choosye/Cyberdeckie/BOM.csv

Item | Qty | Supplier | Cost/item | Total Cost | link
TYPE-C-31-M-12 | 1 | LCSC | $0.87 | $0.87 | https://www.lcsc.com/product-detail/C165948.html
TS-1187A-B-A-B | 60 | LCSC | $0.03 | $1.80 | https://www.lcsc.com/product-detail/C318884.html
C3011084 Diode | 50 | LCSC | $0.01 | $0.50 | https://www.lcsc.com/product-detail/C3011084.html
C2998822 FPC Connector | 10 | LCSC | $0.10 | $1.00 | https://www.lcsc.com/product-detail/C2998822.html
BQ24074 charger chip | 1 | LCSC | $5.45 | $5.45 | https://www.lcsc.com/product-detail/C54313.html
C431540 Slide Switch | 1 | LCSC | $0.52 | $0.52 | https://www.lcsc.com/product-detail/C431540.html
C919459 | 1 | LCSC | $1.15 | $1.15 | https://www.lcsc.com/product-detail/C919459.html
C285716 | 1 | LCSC | $0.63 | $0.63 | https://www.lcsc.com/product-detail/C285716.html
C21190 1k Resistor | 1 | LCSC | $0.16 | $0.16 | https://www.lcsc.com/product-detail/C21190.html
C22843 1.5k Resistor | 2 | LCSC | $0.10 | $0.20 | https://www.lcsc.com/product-detail/C22843.html
C23186 5.1k Resistor | 2 | LCSC | $0.08 | $0.16 | https://www.lcsc.com/product-detail/C23186.html
C25804 10k Resistor | 1 | LCSC | $0.16 | $0.16 | https://www.lcsc.com/product-detail/C25804.html
C25803 100k Resistor | 1 | LCSC | $0.28 | $0.28 | https://www.lcsc.com/product-detail/C25803.html
C22833 1.13k Resistor | 1 | LCSC | $0.19 | $0.19 | https://www.lcsc.com/product-detail/C22833.html
C22763 1.18k Resistor | 1 | LCSC | $0.16 | $0.16 | https://www.lcsc.com/product-detail/C22763.html
C23239 732k Resistor | 1 | LCSC | $0.24 | $0.24 | https://www.lcsc.com/product-detail/C23239.html
Capacitors | 1 | LCSC | $3.39 | $3.39 | https://lcsc.com
C131337 Connector Header | 1 | LCSC | $0.54 | $0.54 | https://www.lcsc.com/product-detail/C131337.html
C5173392 2x20 Header | 1 | LCSC | $1.26 | $1.26 | https://www.lcsc.com/product-detail/C5173392.html
LEDs | 1 | LCSC | $1.79 | $1.79 | https://lcsc.com
C3013203 46.4k Resistor | 1 | LCSC | $0.16 | $0.16 | https://www.lcsc.com/product-detail/C3013203.html
PCB | 1 | JLCPCB | $2.00 | $2.00 | https://jlcpcb.com
ST7796 Display | 1 | Aliexpress | $7.55 | $7.55 | https://www.aliexpress.com/item/1005012619618051.html?mp=1
FPC Cable | 1 | Aliexpress | $0.78 | $0.78 | https://www.aliexpress.com/item/1005008216923733.html?mp=1
C52016391 3 Pin Header | 1 | LCSC | $0.45 | $0.45 | https://www.lcsc.com/product-detail/C52016391.html
LiPo Battery | 1 | Aliexpress | $1.93 | $1.93 | https://www.aliexpress.com/item/1005009606905538.html?src=google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
Raspberry Pi Zero 2 W | 1 | element14 | $17.14 | $17.14 | https://sg.element14.com/raspberry-pi/rpi-zero-w-v2/sbc-rpi-zero-2-w-512mb-1ghz/dp/3838499
Estimated total shipping | 1 |  |  | $22.34
