choosye/Cyberdeckie/Hardware/Cyberdeckie Enclosure.step

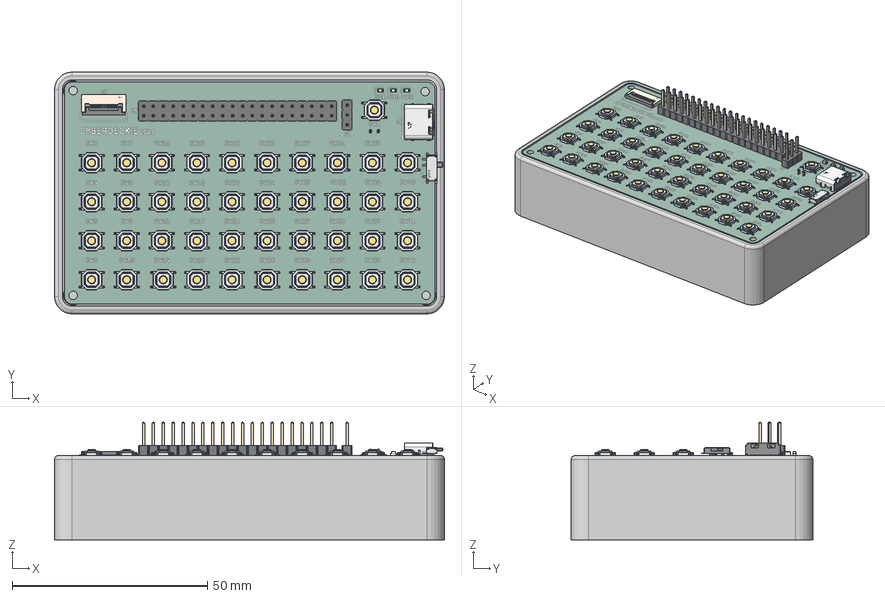
[picture p1: CAD file, 2026-11-13]
Hardware/Cyberdeckie Enclosure.step
100.0 x 62.0 x 30.1 mm
