choosye/Cyberdeckie/(list of files, cad)

Other CAD files:
Hardware/Cyberdeckie Enclosure.f3d
Hardware/Cyberdeckie Enclosure.stl
