choosye/Cyberdeckie/PCB/Cyberdeckie.kicad_pcb

## KiCad design PCB/Cyberdeckie.kicad_pcb (2026-11-13)

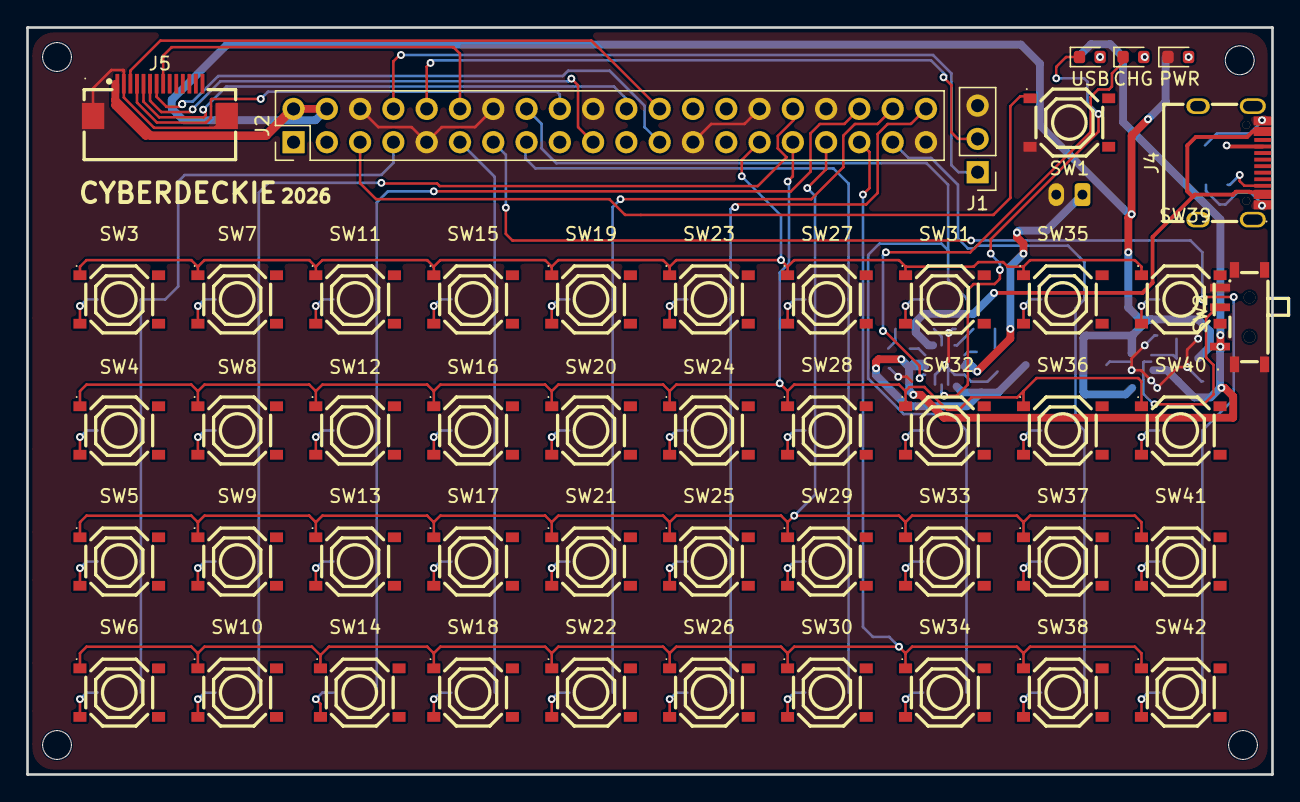
[picture p2: board Cyberdeckie.kicad_pcb from above]

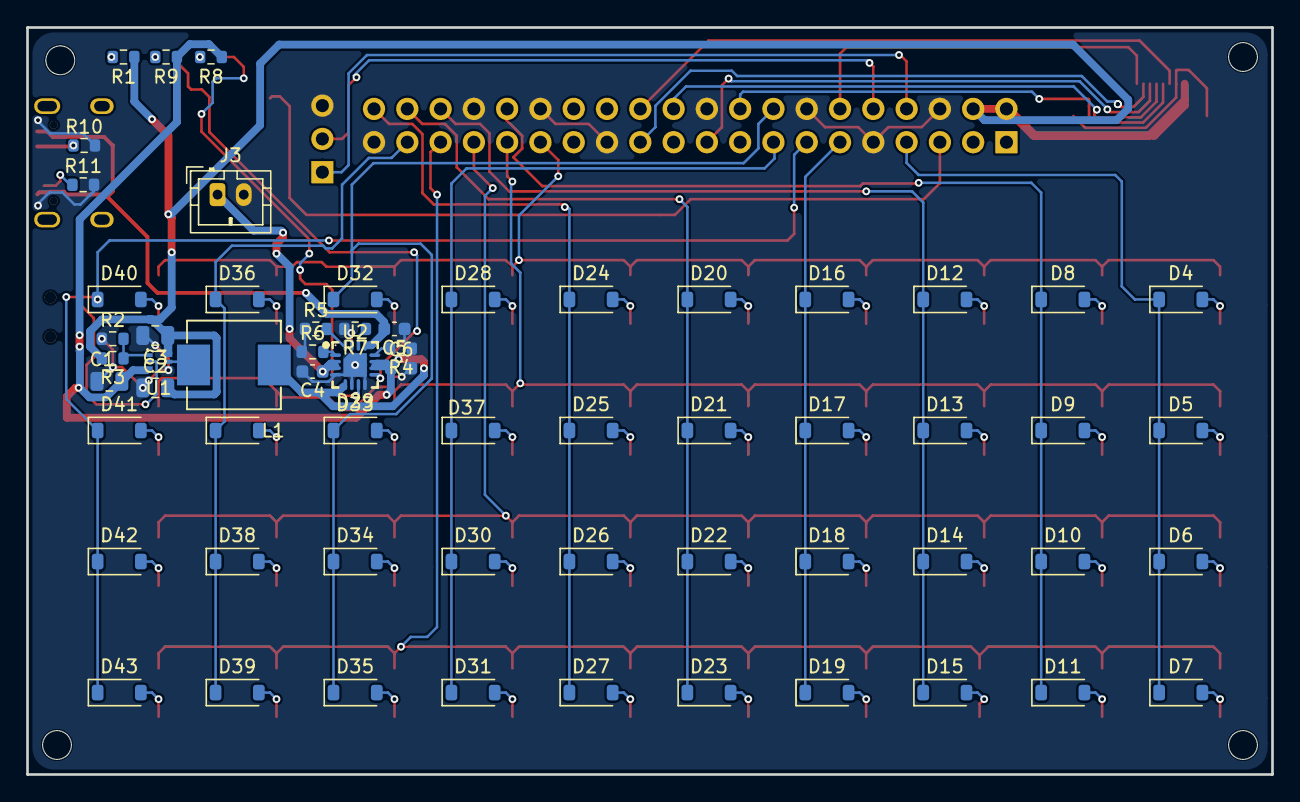
[picture p3: board Cyberdeckie.kicad_pcb from below]

Board: 2 copper layers, 95.0 x 57.0 mm, 110 parts (61 on the bottom side), 82 nets.

Parts:
C1: 10uF; C_0805_2012Metric
C2, C3: 22uF; C_0805_2012Metric
C4, C6: 4.7uF; C_0603_1608Metric
C5: 1uF; C_0603_1608Metric
D1, D2, D3: LED; LED_0603_1608Metric
D4, D5, D6, D7, D8, D9, D10, D11, D12, D13, D14, D15, D16, D17, D18, D19, D20, D21, D22, D23, D24, D25, D26, D27, D28, D29, D30, D31, D32, D33, D34, D35, D36, D37, D38, D39, D40, D41, D42, D43: D; D_SOD-123
J1: Serial Debug; PinHeader_1x03_P2.54mm_Vertical
J2: Raspberry_Pi_Zero_2_W; PinHeader_2x20_P2.54mm_Vertical
J3: Battery (JST-PH); JST_PH_B2B-PH-K_1x02_P2.00mm_Vertical
J4: TYPE-C-31-M-12; USB-C_SMD-TYPE-C-31-M-12_1
J5: ST7796 3.5in Display (FPC); FPC-SMD_14P-P0.50_DEALON_FC05-S14FCT-00
L1: 1uH; IND-SMD_L7.3-W6.6_MHCI06030
R1: 1k; R_0603_1608Metric
R2: 100k; R_0603_1608Metric
R3: 732k; R_0603_1608Metric
R4: 1.18k; R_0603_1608Metric
R5: 1.13k; R_0603_1608Metric
R6: 10k; R_0603_1608Metric
R7: 46.4k; R_0603_1608Metric
R8, R9: 1.5k; R_0603_1608Metric
R10, R11: 5.1; R_0603_1608Metric
SW1, SW3, SW4, SW5, SW6, SW7, SW8, SW9, SW10, SW11, SW12, SW13, SW14, SW15, SW16, SW17, SW18, SW19, SW20, SW21, SW22, SW23, SW24, SW25, SW26, SW27, SW28, SW29, SW30, SW31, SW32, SW33, SW34, SW35, SW36, SW37, SW38, SW39, SW40, SW41, SW42: TS-1187A-B-A-B; SW-SMD_4P-L5.1-W5.1-P3.70-LS6.5-TL_H1.5
SW2: MSK12C02; SW-TH_MSK12C02
U1: TPS61023DRLR; SOT-563_L1.6-W1.2-P0.50-LS1.6-BR
U2: BQ24074RGTR; QFN-16_L3.0-W3.0-P0.50-TL-EP1.7

Connections:
+5V: C2.2, C3.1, J2.2 (5V), J2.4 (5V), J5.1, R1.1, R3.2, U1.6 (VOUT)
COL0: D4.1 (K), D5.1 (K), D6.1 (K), D7.1 (K), J2.7 (GCLK0/GPIO4)
COL1: D8.1 (K), D9.1 (K), D10.1 (K), D11.1 (K), J2.32 (PWM0/GPIO12)
COL2: D12.1 (K), D13.1 (K), D14.1 (K), D15.1 (K), J2.36 (GPIO16)
COL3: D16.1 (K), D17.1 (K), D18.1 (K), D19.1 (K), J2.11 (GPIO17)
COL4: D20.1 (K), D21.1 (K), D22.1 (K), D23.1 (K), J2.38 (GPIO20/MOSI1)
COL5: D24.1 (K), D25.1 (K), D26.1 (K), D27.1 (K), J2.40 (GPIO21/SCLK1)
COL6: D28.1 (K), D29.1 (K), D30.1 (K), D31.1 (K), J2.15 (GPIO22)
COL7: D32.1 (K), D33.1 (K), D34.1 (K), D35.1 (K), J2.16 (GPIO23)
COL8: D36.1 (K), D37.1 (K), D38.1 (K), D39.1 (K), J2.37 (GPIO26)
COL9: D40.1 (K), D41.1 (K), D42.1 (K), D43.1 (K), J2.13 (GPIO27)
GND: C1.1, C2.1, C3.2, C4.2, C5.1, C6.2, D1.1 (K), J1.3, J2.6 (GND), J2.9 (GND), J2.14 (GND), J2.20 (GND), J2.25 (GND), J2.30 (GND), J2.34 (GND), J2.39 (GND), J3.2, J4.A1B12 (GND), J4.B1A12 (GND), J5.2, J5.15, J5.16, R2.1, R4.1, R5.1, R6.1, R7.2, R10.2, R11.2, SW1.3 (C), SW2.3, SW2.4, U1.4 (GND), U2.4 (~CE), U2.6 (EN1), U2.8 (VSS), U2.17 (EP)
LCD_BL: J2.12 (GPIO18/PWM0), J5.8
LCD_CS: J2.24 (~CE0/GPIO8), J5.3
LCD_DC: J2.22 (GPIO25), J5.5
LCD_MOSI: J2.19 (MOSI0/GPIO10), J5.6
LCD_RST: J2.18 (GPIO24), J5.4
LCD_SCK: J2.23 (SCLK0/GPIO11), J5.7
unnamed: D1.2 (A), R1.2
unnamed: D2.2 (A), R8.1
unnamed: D2.1 (K), U2.7 (~PGOOD)
unnamed: D3.2 (A), R9.1
unnamed: D3.1 (K), U2.9 (~CHG)
unnamed: D4.2 (A), SW3.3 (C)
unnamed: D5.2 (A), SW4.3 (C)
unnamed: D6.2 (A), SW5.3 (C)
unnamed: D7.2 (A), SW6.3 (C)
unnamed: D8.2 (A), SW7.3 (C)
unnamed: D9.2 (A), SW8.3 (C)
unnamed: D10.2 (A), SW9.3 (C)
unnamed: D11.2 (A), SW10.3 (C)
unnamed: D12.2 (A), SW11.3 (C)
unnamed: D13.2 (A), SW12.3 (C)
unnamed: D14.2 (A), SW13.3 (C)
unnamed: D15.2 (A), SW14.3 (C)
unnamed: D16.2 (A), SW15.3 (C)
unnamed: D17.2 (A), SW16.3 (C)
unnamed: D18.2 (A), SW17.3 (C)
unnamed: D19.2 (A), SW18.3 (C)
unnamed: D20.2 (A), SW19.3 (C)
unnamed: D21.2 (A), SW20.3 (C)
unnamed: D22.2 (A), SW21.3 (C)
unnamed: D23.2 (A), SW22.3 (C)
unnamed: D24.2 (A), SW23.3 (C)
unnamed: D25.2 (A), SW24.3 (C)
unnamed: D26.2 (A), SW25.3 (C)
unnamed: D27.2 (A), SW26.3 (C)
unnamed: D28.2 (A), SW27.3 (C)
unnamed: D29.2 (A), SW28.3 (C)
unnamed: D30.2 (A), SW29.3 (C)
unnamed: D31.2 (A), SW30.3 (C)
unnamed: D32.2 (A), SW31.3 (C)
unnamed: D33.2 (A), SW32.3 (C)
unnamed: D34.2 (A), SW33.3 (C)
unnamed: D35.2 (A), SW34.3 (C)
unnamed: D36.2 (A), SW35.3 (C)
unnamed: D37.2 (A), SW36.3 (C)
unnamed: D38.2 (A), SW37.3 (C)
unnamed: D39.2 (A), SW38.3 (C)
unnamed: D40.2 (A), SW39.3 (C)
unnamed: D41.2 (A), SW40.3 (C)
unnamed: D42.2 (A), SW41.3 (C)
unnamed: D43.2 (A), SW42.3 (C)
unnamed: J4.A5 (CC1), R10.1
unnamed: J4.B5 (CC2), R11.1
unnamed: SW2.2, U1.2 (EN)
unnamed: R2.2, R3.1, U1.1 (FB)
unnamed: L1.2, U1.5 (SW)
unnamed: R4.2, U2.12 (ILIM)
unnamed: R5.2, U2.16 (ISET)
unnamed: R7.1, U2.14 (TMR)
unnamed: R6.2, U2.1 (TS)
ROW0: J2.29 (GCLK1/GPIO5), SW3.1 (A), SW7.1 (A), SW11.1 (A), SW15.1 (A), SW19.1 (A), SW23.1 (A), SW27.1 (A), SW31.1 (A), SW35.1 (A), SW39.1 (A)
ROW1: J2.31 (GCLK2/GPIO6), SW4.1 (A), SW8.1 (A), SW12.1 (A), SW16.1 (A), SW20.1 (A), SW24.1 (A), SW28.1 (A), SW32.1 (A), SW36.1 (A), SW40.1 (A)
ROW2: J2.33 (PWM1/GPIO13), SW5.1 (A), SW9.1 (A), SW13.1 (A), SW17.1 (A), SW21.1 (A), SW25.1 (A), SW29.1 (A), SW33.1 (A), SW37.1 (A), SW41.1 (A)
ROW3: J2.35 (GPIO19/MISO1), SW6.1 (A), SW10.1 (A), SW14.1 (A), SW18.1 (A), SW22.1 (A), SW26.1 (A), SW30.1 (A), SW34.1 (A), SW38.1 (A), SW42.1 (A)
SHUTDOWN: J2.5 (SCL/GPIO3), SW1.1 (A)
UART_RX: J1.2, J2.10 (GPIO15/RXD)
UART_TX: J1.1, J2.8 (GPIO14/TXD)
VBAT: C4.1, J3.1, U2.2 (BAT), U2.3 (BAT)
VBUS: C5.2, J4.A4B9 (VBUS), J4.B4A9 (VBUS), U2.13 (IN)
VSYS: C1.2, C6.1, L1.1, R8.2, R9.2, SW2.1, U1.3 (VIN), U2.5 (EN2), U2.10 (OUT), U2.11 (OUT)
