choosye/Cyberdeckie/JOURNAL.md

# Cyberdeckie: devlog

<!-- Generated by Half Life from project c2gtuuxphvi9iicwg3xbcl76. Edits here are overwritten on the next sync. -->
<!-- Generated: 2026-11-13T23:14:41.680Z -->

> [!NOTE]
> This devlog is mirrored from [Half Life](https://halflife.hackclub.com) ([open the project](https://halflife.hackclub.com/projects/c2gtuuxphvi9iicwg3xbcl76)). Editing it here will not change the platform's copy, and the next sync overwrites this file.

> A custom-built cyberdeck from scratch!! A tiny Linux-based computer that will make you feel like a hacker from the '90s!

| Week | Tier | Hours logged | Entries |
| --- | --- | --- | --- |
| Week 5 | Tier 2 | 36.75h | 9 |

## Contents

1. [2026-11-09: Starting off Cyberdeckie](#2026-11-09-starting-off-cyberdeckie)
2. [2026-11-10: Making the schematic for power parts; the big learning point](#2026-11-10-making-the-schematic-for-power-parts-the-big-lear)
3. [2026-11-10: 10/11: Completing the schematic](#2026-11-10-1011-completing-the-schematic)
4. [2026-11-11: 11/11: PCB Editing time!!!](#2026-11-11-1111-pcb-editing-time)
5. [2026-11-11: 11/11: Finishing up the PCB YAYYYY](#2026-11-11-1111-finishing-up-the-pcb-yayyyy)
6. [2026-11-12: 12/11: ROUTING TIME!](#2026-11-12-1211-routing-time)
7. [2026-11-13: 13/11: Last last session to really complete the PCB](#2026-11-13-1311-last-last-session-to-really-complete-the-pcb)
8. [2026-11-13: 13/11: Last stretch! Finding and creating the BOM](#2026-11-13-1311-last-stretch-finding-and-creating-the-bom)
9. [2026-11-13: Creating the Enclosure](#2026-11-13-creating-the-enclosure)

## Design

### 2026-11-09: Starting off Cyberdeckie

**4h**

Starting off Cyberdeckie

CyberdeckieSS0
Screenshot 2026-11-09 at 9.05.02 AM
First off, I had to pick which parts to use for my cyberdeckie. It took a considerable amount of time to find everything. Managed to get most of the parts from lcsc, so that’s good! After that, i downloaded all of the datasheets so that i could refer to them when making the schematic.

CyberdeckieSS1
CyberdeckieSS2
Started on the schematic!! For this project, I made multiple pages, grouping them into RPi, Power, Display and Keyboard. Started with the Raspberry Pi and added the net labels.

### 2026-11-10: Making the schematic for power parts; the big learning point

**5.75h**

Making the schematic for power parts; the big learning point

CyberdeckieSS3
Started with the USB-C, which was quite straightforward. Referred to the datasheet pinout
Looking back now I actually accidentally added vbus as a net label, not a power symbol so I’ll go change that haha

CyberdeckieSS5
Got to the most tedious and challenging part of the schematic, the battery charger (BQ24074)… but i definitely did learn the most here.
So uhhhhh when i saw this my brain couldn’t even process it.. but! I tried to connect whatever I understood first, like connected the pins to the ground.

CyberdeckieSS6
And then came the mighty Google: understanding what the symbols stand for 🫣 i did end up using a diff pic cos this one wasn’t as helpful as the others
This was a great help. Well actually the datasheet did help a ton, especially after I understood it all. After that, i connected the capacitors (which were actually really easy I just didn’t know what they were at first), and then everything else came slowly.

CyberdeckieSS7
Progress! Rough, but progress! Relied a LOT on the datasheet for this component. Also realised that since I was working with different pages, I had to use global net labels, so I switched them all!

CyberdeckieSS8
After I kinda got everything, I ran the ERC and wow so many errors! Turns out something moved in my RPi page and a ton of labels weren’t connected so I moved them back and yayyyy settled :D

CyberdeckieSS9
Lastly, I decided to clean up my power page and labels too bc some of them were kinda redundant. After that, everything was much neater :) Also added the necessary power flags and yay done with the power page fully!

Really didn’t expect to spend so so much time with this page but i definitely did learn a lot. In the end, a lot of time was spent finding which symbols and labels to connect with the pins and also fixing mistakes made.

### 2026-11-10: 10/11: Completing the schematic

**4h**

10/11: Completing the schematic

CyberdeckieSS11
After doing up the power page, I moved on to making the schematic for the display, which was fairly simple.

CyberdeckieSS12
After that, I moved on to the keyboard! Oh gosh... so many keyss... Created the first switch and then duplicated the rows and columns. (Thank goodness for duplication!) However, I still had to change each switches net label to the corresponding one. Well that took a while!

CyberdeckieSS13
After the long long keyboard session, I went back to the RPi page to add a shutdown and button and serial debug header so that everything's safe!

CyberdeckieSS14
CyberdeckieSS15
After that, I ran the DRC to make sure everything was okay and yay omg no errors I love it! I also decided to run the 'annotate schematic' to make sure everything is labelled nicely and neatly :)

### 2026-11-11: 11/11: PCB Editing time!!!

**6.5h**

11/11: PCB Editing time!!!

It was finally time to update the schematic to the PCB!! Well, I was really really excited to move on to the PCB, so I totally forgot about the assigning of footprints so... yeah I ran into a bunch of errors when I tried to update the PCB. whoops!

CyberdeckieSS16
Updated and found all of the footprints! Had to search for and download a few but it wasn't too bad so yayy

CyberdeckieSS17
Managed to updated the PCB from the schematic successfully!! But it wasn't a very pleasant surprise when I saw all of the components. I definitely did not see so many components before and I hadn't worked with these especially, so uh well it was new!

CyberdeckieSS18
I first tried separating the key switches and arrange the keyboard since it was the main part of the PCB. Well, this one took sooooooooooo much time omg I was gonna take my brains out for this. Especially since everything had to be placed specifically, I had to find the different switches one by one while referring to the schematic for which SW to place down. Oh gosh, it really took a lot of time for arranging the PCB.

Screenshot 2026-11-12 at 9.22.29 PM
YAY progress! It was still a little messy but I was getting the hang of putting the different switches in place and tidying the row to be on the same level. Wasn't too sure on how to tidy the columns yet though heh

Screenshot 2026-11-12 at 9.39.12 PM
FINALLY DONE with placing all of the switches! And then came the diodes...

Screenshot 2026-11-12 at 9.50.54 PM
Actually forgot B.cu existed so I was like omg do I have to place the diodes right beside the switches? but nope luckily not because we love B.cu and it's so much neater that way. Love just having to place them in the middle of the switch! This one also took a while since I had to find the individual diodes for the specific switches. Glad I managed to get that done though!

Screenshot 2026-11-12 at 11.06.47 PM
After getting the base keyboard down, I added in the rest of the larger components like the FPC connector, RPi connector and battery stuff. Did not want to touch the power components bc I did not know how I was supposed to do those and they were so much smaller than I imagined.

### 2026-11-11: 11/11: Finishing up the PCB YAYYYY

**4h**

11/11: Finishing up the PCB YAYYYY

Screenshot 2026-11-12 at 11.06.47 PM
First off, I added every single component into the PCB (except the Rs and Cs!) , since I left some out the last session. Had the power components on the B.cu so that everything would be neater! Plus, they weren't needed on the front side anyway.

Screenshot 2026-11-13 at 6.17.29 AM
After that, I focused on the power components (yeah did not expect how long it would eventually take...) Firstly, I wasn't even sure where to put the resistors. Yeah.
So, I had to pull out the good ol datasheet. Didn't think I'd have to use it again... But yes it was very useful.

Screenshot 2026-11-13 at 6.24.23 AM
After referring back and forth for who knows how long, I finally finally got the resistors to the best placement I could get. So now every component is in the PCB woohoo!

Screenshot 2026-11-13 at 6.29.15 AM
Ran the DRC and um..... Too many violations? Yeah so I googled it and apparentlyyyy it should be fine. Hopefully. Because yeah I ended up ignoring that + the clearance violations since I needed the slide switch and usb to be really near the edge.

Screenshot 2026-11-13 at 3.13.36 PM
I focused on completing the design of the PCB for this session so yay done after!

### 2026-11-12: 12/11: ROUTING TIME!

**6h**

12/11: ROUTING TIME!

Oohohohoh routing routing routing, the big boss. This one really took a toll on me TT^TT since there was so much to route for this project. (So far, they've been pretty simple since I'd just been following the guide).

Screenshot 2026-11-13 at 3.31.30 PM
Before starting, I made some additions to the board setup; making the track width for the power net class thicker so that more current for the power can flow through and it won't overheat too easily!

Screenshot 2026-11-13 at 4.10.28 PM
Starting off the routing, which I briefly forgot which key to press (x) but it was easy after the tiny refresher, I connected the pads on the key switches. Did the rows on F.cu and the columns on B.cu. Left some unconnected since there was a lot going on at the cluster of power components. This was the easiest part of routing. :(

Screenshot 2026-11-13 at 4.27.10 PM
After the key switches, I moved on to route as much as I could at the FPC connector yay! I learned that I had to make the routes as close as possible to leave enough space for more routing (experience!) I also tried to route all of the main column and row switches to the RPi pins. I definitely need to work on my routing looks wise, but its a lot better than my first few projects ;>

Screenshot 2026-11-13 at 4.49.15 PM
More, more, more routing!! Got a lot more done here, and tried to connect all of the GND pins first (which I would later deeply regret...) since I thought hey there are the most number of gnd pins let's do them first then
And these actually took quite long too :<

CyberdeckieSS20
Oh gosh ran into so many problems with this project. For this screenshot above, I was really frustrated because I couldn't seem to move the track anywhere. Literally. Apparently, it was because the track was too thick since it was a power pad and couldn't move past the gap between the R1 and hole. Omg. I  was stuck staring at this after putting it off for as long as I could already and just couldn't figure it out. Yeah so what I did in the end was creating pre-defined sizes for the track and switching to that instead. It worked like a charm.

Screenshot 2026-11-13 at 6.38.53 PM
Kinda forgot to take more screenshots so this is already after quite a while but some context here anyway: When I was trying to route all of the pins, especially those at the power components, I couldn't route them because they were all blocked by the multiple gnd tracks... It was so so so annoying but I still worked my way around it somehow(?) although it was really messy. However, there were 1 or 2 pins that just couldn't move because it was blocked by everything around and I couldn't swap it to F.cu either cos there was just not enough space. So, I googled a little here and there and of course I realised I didn't need to connect all of the gnd pads because there's a thing called gnd pour (week 1...) sigh so yeah I painstakingly removed all of the gnd connections to make sure I could route everything else first. And it worked so so so much better. Yes, it does still look messy, but at least they connect!

### 2026-11-13: 13/11: Last last session to really complete the PCB

**2.5h**

13/11: Last last session to really complete the PCB

Screenshot 2026-11-13 at 6.46.24 PM
After routing what I thought was needed (excluding gnd) I went ahead with the ERC and found a few pads still unconnected so I went ahead and did that until only the gnd pads were left so that I could finally do the gnd pour.

Screenshot 2026-11-13 at 8.19.22 PM
Didn't take enough screenshots again but anyway. Forgot how to do a gnd pour so thank you youtube! After the gnd pour, a few gnd pads were still unrouted so  I went ahead and routed those manually and everything was routed and good!

After seeing the final PCB, I felt a huge sense of accomplishment!

Screenshot 2026-11-14 at 12.04.04 AM
But of course, you aren't done with your PCB without your silkscreen art :D
However, since I was short on time, I decided to just stick with my cyberdeckie name, year, and also labels for the LEDs for future reference. I wish I did more for the art, but there wasn't much space to begin with anyway so it was okay

### 2026-11-13: 13/11: Last stretch! Finding and creating the BOM

**2h**

13/11: Last stretch! Finding and creating the BOM

Screenshot 2026-11-14 at 12.10.25 AM
First, I exported the necessary files (gerbers) from kicad and then put it into jlcpcb to get my quote!

Screenshot 2026-11-14 at 12.07.15 AM
This one wow ok it is the most I've done for any project, so I had a lot of components to find.
Luckily though, a lot of components could be found in LCSC so that was good! I spent a great amount of time finding each component with the correct specifications and also had to make sure they weren't too expensive.

### 2026-11-13: Creating the Enclosure

**2h**

Creating the Enclosure

Screenshot 2026-11-14 at 6.46.09 AM
Added in the PCB so that I could easily get the right dimensions!

Screenshot 2026-11-14 at 7.05.56 AM
I decided to make a really simple tray to just hold the PCB since I didn't have enough time

Screenshot 2026-11-14 at 7.06.29 AM
Added in pillars/screws for the PCB to go on through its mounting holes so that it'd sit snugly and not move around too much.

Screenshot 2026-11-14 at 8.05.10 AM
Added the lid for the display and that's the minimum for the enclosure so yay done!!

Planning to revise the design in the future but I just needed to make it exist first!
