choosye/Cyberdeckie/(commit log)

2026-11-02 Sync Cyberdeckie from Half Life
    [BOM.csv]
2026-11-13 Add PCB section with image to README
    Added PCB image to the README for better visualization.
